blacksnake200212-del/FYP_SDAS/hardware_schematic/circuit_schematic.png

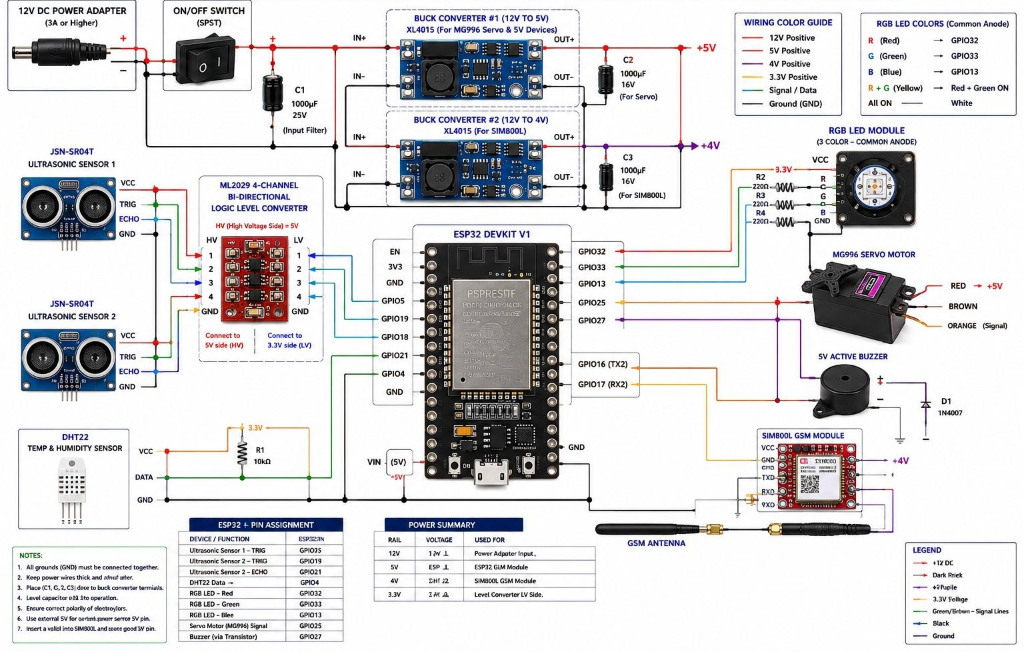
hardware_schematic/circuit_schematic.png
