blacksnake200212-del/FYP_SDAS/docs/SDAS_Updated_Proposal.pdf

# Smart Dam Alert System with Automated Gate Control

## Revised System Proposal & Hardware Implementation Specification

Dias Adrian (Cyber Security) | AAA Aadhil (Data Science) | JMRA Dilshan (Software Engineering)
Supervisor: Dr. Sanika Wijayasekara (Data Science & Cyber Security) | Co-supervisor: Mr. Kavinda Tharindu (Data
Science)
Faculty of Computing and IT, SLTC Research University, Ingiriya Road, Meepe, Sri Lanka

## 1. Introduction

Floods in the Puttalam region of Sri Lanka occur with catastrophic regularity due to the lack of automation in regional dam monitoring and spillway regulation. Manually dispatched gate operations currently incur response delays exceeding 30 to 45 minutes during rapid inflow surges, resulting in widespread agricultural destruction, loss of property, and fatal human casualties. The Smart Dam Alert System (SDAS) solves this vulnerability by engineering a fully integrated, low-latency (<2.0s), dual-redundant IoT hardware prototype coupled with a cloud backend (Supabase), cloud-hosted machine learning inference (TensorFlow LSTM and Autoencoder), multi-stage GSM SMS broadcasts, and two React Native mobile applications (Public and Operator).

### 1.1 Summary of Literature

Weerasinghe et al. [1] formulated functional criteria for Early Warning Systems (EWS) to minimize dam breach probabilities in Sri Lanka, emphasizing hydrological risk profiling but omitting an automated physical actuator and sensor prototype. Sasikala et al. [2] demonstrated an IoT water-monitoring framework using ultrasonic sensing for reservoir acquisition, but lacked automated gate control, hardware-level sensor redundancy, and staged community warnings. Nirmal and Shekapure [3] investigated AI algorithms for dam flood management, yet their framework lacked multi-tier public alerting and localized offline fail-safe execution.

### 1.2 Research Gap & 1.3 Problem Definition

Existing solutions suffer from critical voids: (a) systems monitor water levels but defer gate regulation to delayed manual intervention; (b) automated gates dispatch generic SMS without localized tiered warnings or dual mobile applications; (c) cloud ML architectures lack local edge fallback, risking dam safety when communication fails. SDAS directly bridges these gaps through: (i) dual-redundant waterproof ultrasonic sensing with real-time temperature compensation; (ii) local autonomous gate regulation (<2s latency) via high-torque servo actuation with 3% hysteresis; (iii) cloud-connected advisory ML for 1-hour ahead water level prediction and sensor anomaly detection; (iv) an autonomous 3-stage emergency warning system (Buzzer, RGB LED, SIM800L SMS); and (v) twin mobile interfaces tailored for citizens (login-free) and dam operators (authenticated).

### 1.4 Research Questions & 2. Goal of the Project

This project investigates: (1) How can dual waterproof ultrasonic sensors with acoustic temperature compensation achieve resilient ±2.0 cm water level precision? (2) What autonomous state machine ensures safe, oscillation-free gate regulation while supporting instantaneous operator override? (3) Can staged SMS and audible alerts notify emergency responders within <10 seconds? (4) How effectively can cloud-hosted LSTM and Autoencoder models deliver advisory flood forecasts (MAPE < 5%) and flag sensor failures? (5) How can two distinct mobile applications serve both community awareness and authenticated operator control?

## 3. Aims and Objectives

- Hardware Prototype: Fabricate a robust physical prototype with ESP32 DevKit V1, dual JSN-SR04T waterproof ultrasonic sensors, DHT22 sensor, MG996R metal-gear servo actuator, SIM800L GSM, RGB LED, active buzzer, and dual XL4015 buck converters.
- Resilient Firmware: Implement C/C++ firmware executing deterministic local decision-making (<2s response time) with a 3% hysteresis band, operational even during complete network or cloud outages.
- Advisory Cloud Machine Learning: Deploy an LSTM model for 1-hour ahead water level forecasting (MAPE < 5%) and an Autoencoder for sensor anomaly detection running on a cloud inference server, providing decision support without compromising local gate safety.
- Staged Multi-Tier Warning: Dispatch coordinated audible, visual, and SIM800L GSM SMS notifications across Normal, Pre-Warning, Clear-Area, and Danger stages.
- Dual Mobile Apps: Develop two React Native (Expo) applications: a Public App for login-free community alerts and an Operator App for authenticated monitoring and remote gate override.
SLTC Research University | Faculty of Computing & IT | Final Year Project | Page 1 of 4

## 4. System Hardware Architecture & Power Engineering

To elevate the prototype from basic hobby components to industrial-grade reliability, key hardware selections were revised from the preliminary draft. Gate actuation utilizes the MG996R Metal-Gear High-Torque Servo Motor (controlled via ESP32 PWM on GPIO25) rather than an on/off DC motor and relay, enabling precise continuous aperture regulation (0% to 100%). Water level detection employs dual JSN-SR04T waterproof ultrasonic sensors with an ML2029 4-channel bi-directional logic level converter, delivering IP67 environmental resilience and dual-sensor fault cross-validation (while maintaining software compatibility with HC-SR04 sensors for bench testing). A DHT22 temperature sensor dynamically compensates for variations in the acoustic speed of sound: v = 331.3 + (0.606 × T) m/s.

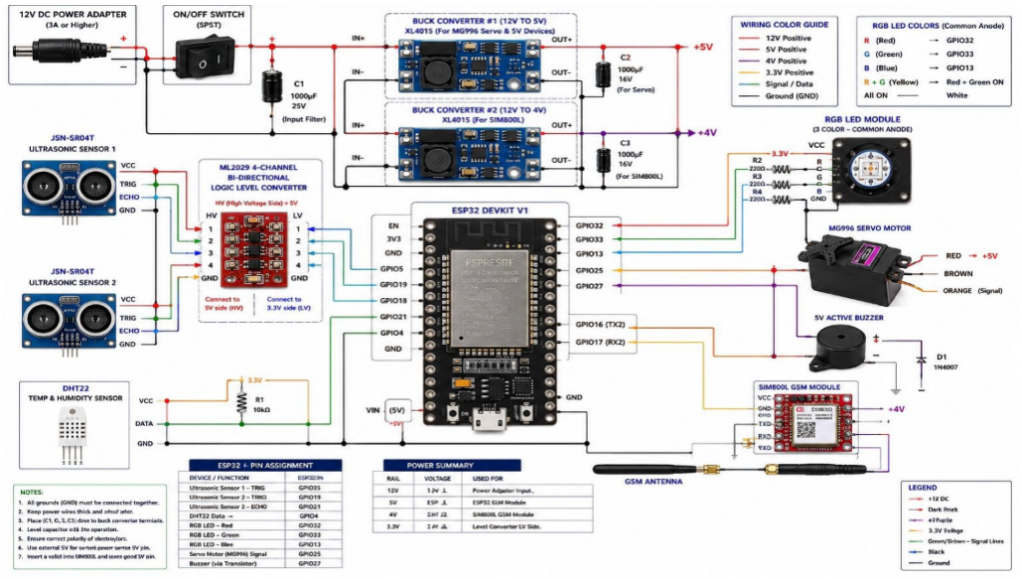
[picture p5: figure]

Figure 1: SDAS Complete Hardware Wiring Schematic, Pin Assignments, and Dual-Rail Power Distribution Network.

Power Distribution Network: Operating the ESP32, MG996R servo, and SIM800L module from a single unregulated rail causes severe voltage sags and microcontroller brownouts due to servo stall currents (>1.5A) and SIM800L 2G transmission bursts (up to 2A at 217 Hz). As shown in Figure 1, the design implements an isolated dual-rail power topology powered by a 12V 3A DC supply with a 1000 µF 25V input filter (C1):
- Buck Converter #1 (XL4015, 12V to 5V, 1000 µF C2): Supplies 5V for the MG996R servo, ESP32 VIN, Level Converter HV, 5V active buzzer, and JSN-SR04T sensors.
- Buck Converter #2 (XL4015, 12V to 4V, 1000 µF C3): Dedicated 4.0V rail specifically sized for the SIM800L module's stringent 3.7V–4.2V operating window and high pulse currents.
- Common Ground: All ground returns are unified to eliminate ground loops and reference float.

Smart Dam Alert System (SDAS) - Research Proposal & System Specification

SLTC Research University | Faculty of Computing & IT | Final Year Project | Page 2 of 4

### Table 1: ESP32 DevKit V1 Hardware Pin Assignment

Peripheral / Signal | ESP32 Pin | Voltage / Logic | Function / Notes
JSN-SR04T Sensor 1 (TRIG) | GPIO5 | 3.3V LV (5V HV) | Level converter Ch 1; 10 µs trigger pulse
JSN-SR04T Sensor 1 (ECHO) | GPIO19 | 3.3V LV (5V HV) | Level converter Ch 2; pulse width capture
JSN-SR04T Sensor 2 (TRIG) | GPIO18 | 3.3V LV (5V HV) | Level converter Ch 3; redundant trigger
JSN-SR04T Sensor 2 (ECHO) | GPIO21 | 3.3V LV (5V HV) | Level converter Ch 4; redundant echo capture
DHT22 Temp & Humidity | GPIO4 | 3.3V | 10kΩ pull-up to 3.3V; acoustic temp compensation
MG996R Servo (PWM Signal) | GPIO25 | 3.3V PWM (5V VCC) | LEDC PWM 50Hz; gate angle regulation (0°-90°)
5V Active Buzzer | GPIO27 | 3.3V GPIO | Active buzzer via 1N4007 flyback protection
RGB LED (Red Cathode) | GPIO32 | 3.3V (Active LOW) | 220Ω series resistor; Common Anode VCC = 3.3V
RGB LED (Green Cathode) | GPIO33 | 3.3V (Active LOW) | 220Ω series resistor; Common Anode VCC = 3.3V
RGB LED (Blue Cathode) | GPIO13 | 3.3V (Active LOW) | 220Ω series resistor; Common Anode VCC = 3.3V
SIM800L GSM (TX / RX) | GPIO17 / 16 | 3.3V UART2 | HardwareSerial2 (16=TX2 to RXD, 17=RX2 to TXD)

### Table 2: Staged Warning Protocol and Gate Actuation Logic (with 3% Hysteresis)

Status | Reservoir Capacity | MG996R Gate | RGB LED | Buzzer | SMS Alert Broadcast
NORMAL | < 70% | Closed (0% / 0°) | Green | OFF | No SMS; continuous background logging
PRE-WARNING | 70% - 85% (rising) | Opening 20% - 30% (27°) | Yellow (R+G) | Periodic chirp | Pre-warning SMS to all registered contacts
CLEAR-AREA | 70% - 85% (rapid surge) | Progressive 30% - 70% (54°) | Orange | Pulsed beep | 'Clear Downstream Area' SMS broadcast
DANGER | > 85% capacity | Full Open 100% (90°) | Red | Continuous siren | Emergency SMS to operators, police & public

## 5. Proposed Methodology & Machine Learning Architecture

The system coordinates five core architectural layers:
1. Embedded Edge Node: ESP32 firmware executes non-blocking acquisition of dual JSN-SR04T sensors, median filters raw samples, applies temperature compensation, calculates capacity, and enforces the 3% hysteresis state machine (<2s cycle). An offline fail-safe ensures complete operational autonomy if cloud or network links fail.
2. Cloud Backend (Supabase): Serves as the central real-time PostgreSQL database hosting tables for sensor_readings, gate_logs, alarms, and emergency_contacts. Row Level Security (RLS) protects operator command endpoints while enabling public read access.
3. Advisory Machine Learning Engine: Due to hardware constraints on microcontrollers, the ML models run on a cloud/edge FastAPI inference server connected via webhooks. The LSTM neural network ingests a 24-step sequence of past water levels, temperature, and rate-of-rise to forecast water level 1 hour ahead (MAPE < 5%). The Deep Autoencoder reconstructs multi-sensor readings; if Mean Squared Error (MSE) exceeds a statistical threshold, a sensor anomaly/drift alert is flagged within <5 seconds. Crucially, ML outputs serve as advisory decision support for operators rather than unconstrained physical triggers.
4. Mobile Applications (React Native Expo): The Public App provides zero-login real-time dam capacity visualization, staged hazard color banners, 1-hour ML predictions, and Puttalam evacuation maps. The Operator App requires Supabase Auth and provides live dual-sensor telemetry, manual gate override controls (0% to 100%), emergency SMS dispatch triggers, and alarm audit logs.
5. Physical Prototype Testing: Validated on a scaled reservoir rig evaluating sensor accuracy (±2.0 cm), gate cycle durability (100+ cycles), and SMS dispatch latency (<10s).

## 6. Resource Requirements, Ethics, and Risk Management

Hardware: ESP32 DevKit V1, Dual JSN-SR04T waterproof ultrasonic sensors, DHT22 sensor, MG996R servo motor, SIM800L GSM, dual XL4015 buck converters, 12V 3A adapter, common anode RGB LED, 5V active buzzer, 1000 µF filter capacitors, ML2029 logic level converter.
Software: Arduino C/C++ IDE, Python 3.12, TensorFlow / Keras, FastAPI, Supabase Cloud (PostgreSQL, Auth), React Native with Expo SDK.
Ethics & Safety: Only synthetic and historical hydrological data from the Puttalam district (2017–2023) is used; no personal surveillance data is collected. Emergency contact numbers are securely encrypted. Hard-coded physical threshold limits and manual operator overrides prevent software faults from causing hazardous gate movements.
SLTC Research University | Faculty of Computing & IT | Final Year Project | Page 3 of 4

## 7. References

[1] L. N. K. Weerasinghe, M. Thayaparan, and T. Fernando, 'Functional Characteristics of an EWS to Minimise the Risk of Dam Breaks in Sri Lanka,' in Proc. 10th World Construction Symposium, Jun. 2022, pp. 507-517.
[2] G. Sasikala, S. Srinivasan, J. Navarajan, and M. M. Theresa, 'IoT based Water Level Monitoring and Management in Reservoir,' in Proc. 2022 3rd Int. Conf. on Electronics and Sustainable Communication Systems (ICESC), Coimbatore, India, 2022, pp. 1763-1767.
[3] B. Nirmal and S. Shekapure, 'AI-Driven Smart Dam Management System for Enhanced Safety and Flood Prevention,' Journal of Mines, Metals and Fuels, vol. 73, no. 7, 2025, pp. 2137-2145.
[4] Espressif Systems, 'ESP32 Series Datasheet and Hardware Design Guidelines,' Espressif Inc., 2025.
[5] Supabase, 'Supabase Architecture and PostgreSQL Row Level Security Documentation,' 2026. [Online]. Available: https://supabase.com/docs.
[6] Meta Platforms, 'React Native and Expo Cross-Platform Framework Documentation,' 2026. [Online]. Available: https://docs.expo.dev.
SLTC Research University | Faculty of Computing & IT | Final Year Project | Page 4 of 4
