blacksnake200212-del/FYP_SDAS/(commit log)

2026-09-23 Initial commit: Smart Dam Alert System (SDAS) prototype with hardware, ML, firmware, Supabase, and Expo
    [puttalam_hydrology_data.csv]
2026-09-24 Optimize ML service for Render cloud deployment: pin Python 3.11.9, lightweight 5ms pure NumPy inference engine, remove heavy tensorflow dependency
